ljohanon06/ServoControl32/docs/Media/Sevro_PWM_Diagram.png

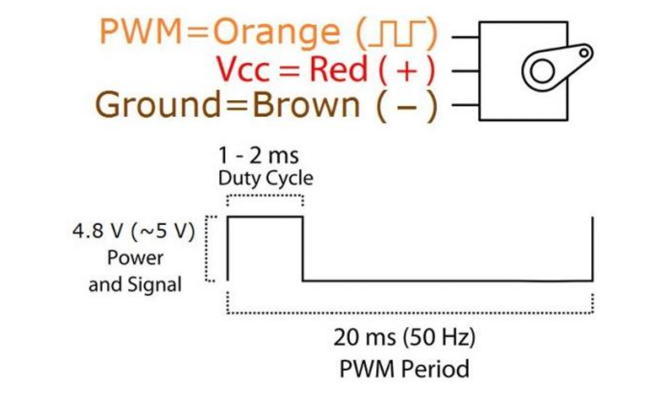
docs/Media/Sevro_PWM_Diagram.png
