ljohanon06/ServoControl32/(list of files, drawings)

Other design files:
Servo_Control_Simulation.ms14
