ljohanon06/ServoControl32/(commit log)

2025-12-22 Add simulation
    [Servo_Control_Simulation.ms14]
2025-12-24 Added PWM diagram
2025-12-24 Add BOM
    [BOM.csv]
2025-12-24 Add schematic image
